gumbypp/Thermo/ios/Thermo/ble_cancel@2x.png

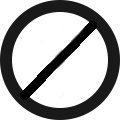
ios/Thermo/ble_cancel@2x.png
