gumbypp/Thermo/ios/Thermo/ble_end@2x.png

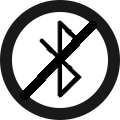
ios/Thermo/ble_end@2x.png
