gumbypp/Thermo/ios/Thermo/ble_start@2x.png

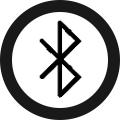
ios/Thermo/ble_start@2x.png
