gumbypp/Thermo/ios/Thermo/Default-568h@2x.png

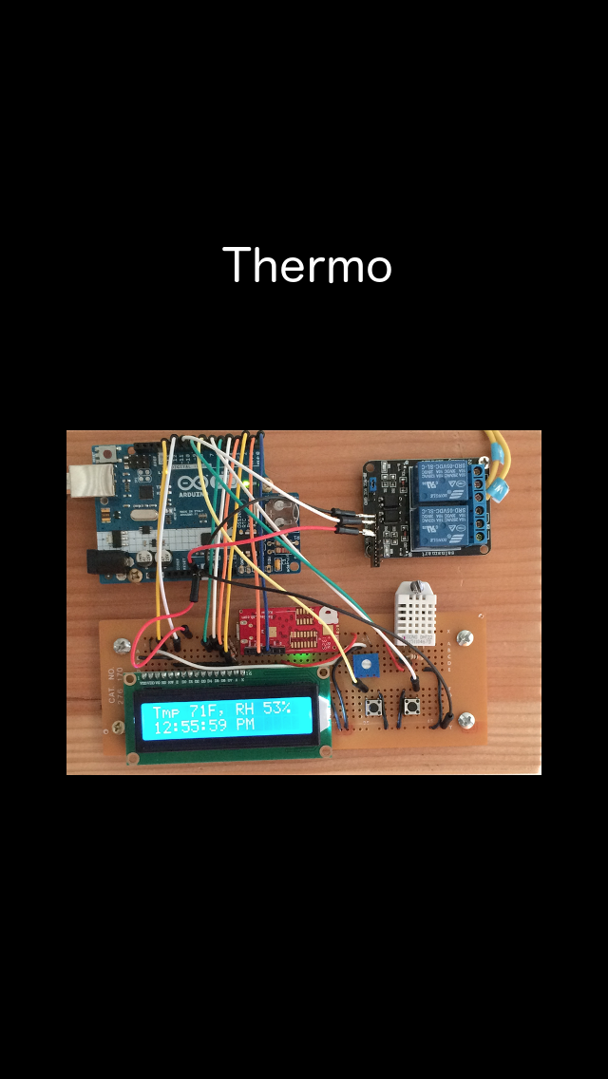
ios/Thermo/Default-568h@2x.png
