gumbypp/Thermo/ios/Thermo/dial@2x.png

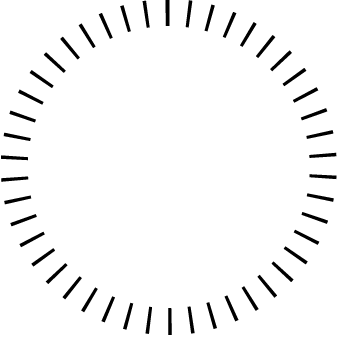
ios/Thermo/dial@2x.png
