gumbypp/Thermo/ios/Thermo/schedule@2x.png

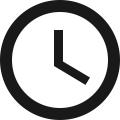
ios/Thermo/schedule@2x.png
